versaloon/versaloon/README

vsprog.texi is the authoritative source of VSProg documentation
