versaloon/versaloon/vsf/hardware/todo.txt

1. Audio Extension
2. UI Extension(16-bit TFT + Touch panel)
3. BLDC Extension
4. Ethernet Extension
5. GSM Extension
6. WIFI Extension
7. ...
