versaloon/versaloon/(threads)

Thread 2 (2015-01-15):

Detection/usb issues (bisected)

swiftgeek, 2015-01-15:
Device: STM32L-Discovery (embedded STlink v2)
• >=1505 fails to work, doesn't need changes in code to compile
• 1443-1504 fails to compile for stm32l-discovery target, after st-link inclusion
  ∘ around time of st-link code enablement
  ∘ commenting out ST-link block - lines 65-73 - makes it compile again!
    ‣ But >1494 revision is not detected anymore by vsprog -L
    ‣ 1485-1493 doesn't compile at all (since common vsfusbd_CDC introduction)
    ‣ 1484 is latest detected after removing st-link lines
• 1442 is last detected revision for STM32L-discovery, and does work (SWD only, which is another issue)
• ~1400 do work/compile (1300 does not!)
In all successful compilation cases past r1400, /dev/ttyACM0 appears with valid PID:VID

As for bootloader i used (after adapting few lines to STM32L-discovery, due to LED/NRST being routed differently) https://github.com/snowcap-electronics/stm-versaloon/tree/master/STM32VL/Bootloader/Simon-BL
Which reminds me that it would be great to use github.io to create nice howto pages for eg. those special targets (i made some photo of connections on mine http://i.imgur.com/BRKidkw.jpg)
Another difference is that jumpers for SWD work just like on original firmware; NRST being not connected to button when board is configured to be powered via CR2032 (via solder bridges); and ofc need of -W1 when programming discovery target

Anyway this is an awesome project and it just misses some git love and documentation (provided via pull request) and improvements to funkier platforms (again pull request… github makes it much easier)

Thread 3 (2015-04-25):

项目中的使用codelite编译工程能重新配置下吗？似乎已经有许多错误了。

code2u, 2015-04-25:
这个项目中使用iar编译versaloon和用msys编译vsprog，已经配置好，编译没有问题。但是里面用codelite编译工程，作为另外一个选择，感觉很有用，但是编译的时候，发现里面的两个工程都有编译链接问题，弄了很长时间解决不了，作者能够重新配置下吗？

versaloon, 2015-04-25:
codelite是很久前配置的，一直没有更新了，近一段时间太忙，没时间去弄这个。另外，vsprog建议使用googlecode里的，github里的有一些改动，以后有空的话，会和googlecode同步的。

code2u, 2015-04-25:
这样啊，确实里面你有许多没更新了，比如iar版本，后来发现要新版本才行，5.4版本打开会丢失配置。另外想问下，vsf这个是怎样一个项目? 因为看到你那个项目一直在更新。

versaloon, 2015-04-25:
VSF是一个软件构架，基于事件驱动构架+事件驱动的PT线程的多任务协作式内核。我这里的一些应用都是用这个构架，包括USB主从协议栈，wifi的tcpip协议栈等。USB主机协议栈和wifi目前没有开源。

code2u, 2015-04-25:
原来如此，感觉你这个开源项目欠缺一些大致的说明，稍微有点乱

versaloon, 2015-04-25:
是的，这个基本只是我自己用的，开源部分代码，是因为有时候需要外包扩这兼职，需要别人看到系统的构架。这个系统构架并非很常用的多任务系统，所以我都是自己培训了之后，别人才能使用的。

code2u, 2015-04-25:
哦，这样。不知你现在忙哪方面，似乎有黑科技味道了，:-)？ 看你博客和versaloon主页，似乎也一直没更新了。

versaloon, 2015-04-25:
也不是黑科技，做一些物联网的东西。目前在弄wifi，以及tcpip协议栈。
