versaloon/versaloon/dongle/hardware/MiniRelease1/VersaloonMiniRelease1.pdf

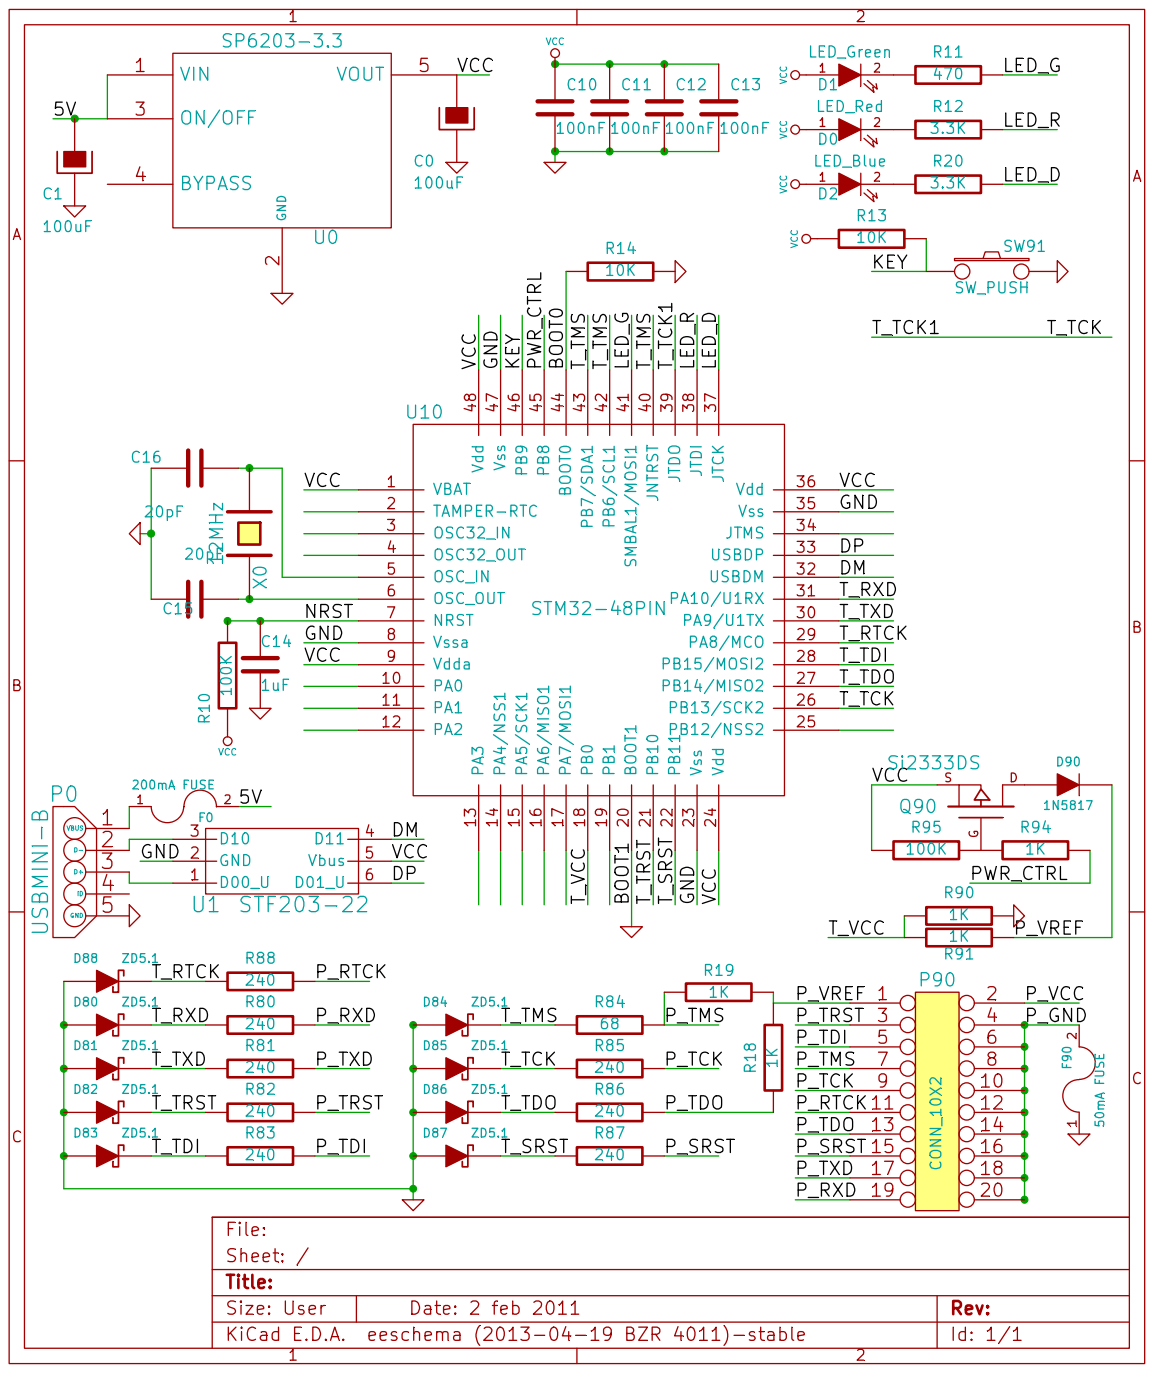
[picture p1: page 1]
