versaloon/versaloon/dongle/hardware/ProRelease3/Versaloon.kicad_pcb

## KiCad design dongle/hardware/ProRelease3/Versaloon.kicad_pcb (2014-08-10)

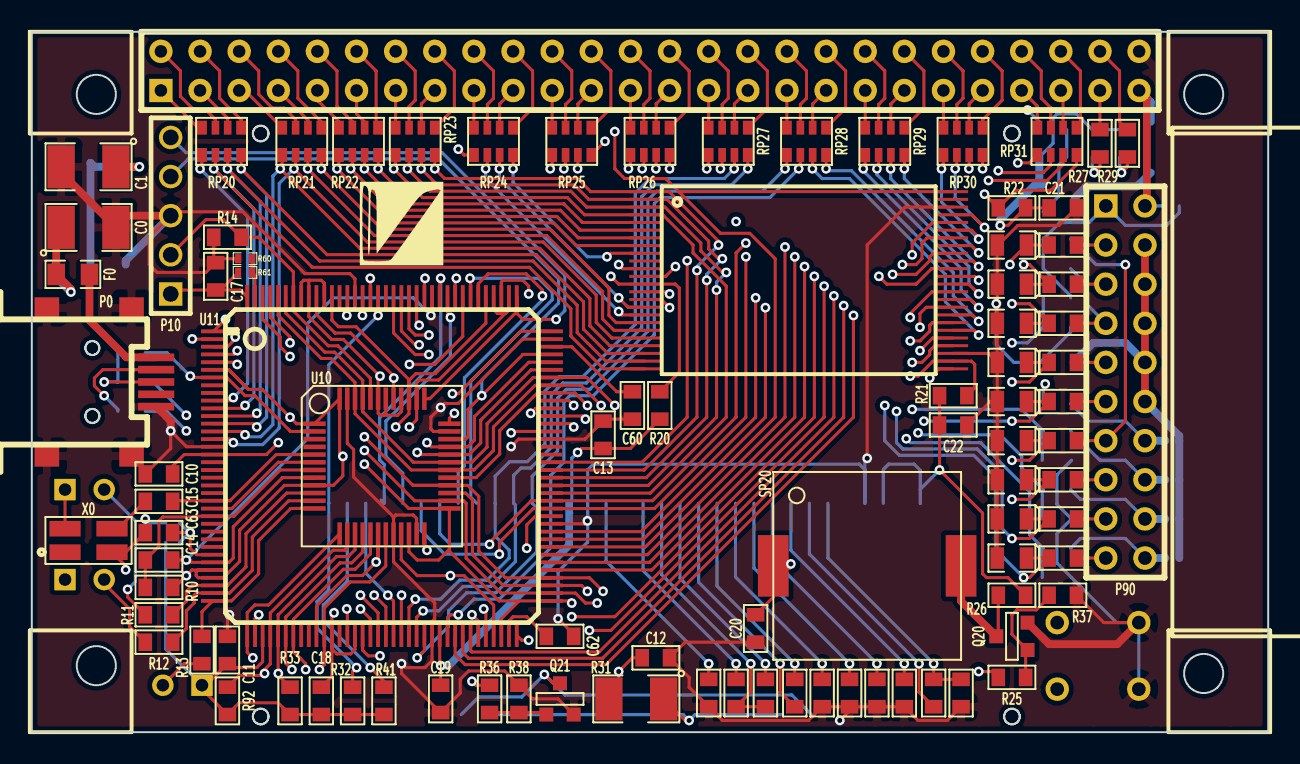
[picture p3: board dongle/hardware/ProRelease3/Versaloon.kicad_pcb from above]

Board: 4 copper layers, 80.3 x 45.5 mm, 129 parts (0 on the bottom side), 184 nets.

Parts:
C0, C1: 100uF; SM1210L
C10, C11, C12, C13, C17, C18, C19, C20, C21, C22, C60, C62, C63: 100nF; SM0603L
C14: 1uF; SM0603L
C15: 100pF; SM0603L
C23, C24, C25, C26, C27, C28, C32: 1uF/25V; SM0603L
C29, C30, C31: 104/25V; SM0603L
D0: LED_Red; LEDV
D1: LED_Green; LEDV
D2: LED_Blue; LEDV
D20, D21: LED_White; DSM0805
D70, D71, D80, D81, D82, D83, D84, D85, D86, D87, D88: ZD5.1; DSM0805
D72: ZD3.3; DSM0805
D90: 1N5817; DSM1206
F0: 200mA_FUSE; SM0805L
F90: 50mA_FUSE; SM0805L
G0: LOGO
LCM20: COG_LCM_33P; COG_12864_33P
P0: USBMINI-B; MINIUSB_A
P10: CONN_5; PIN_ARRAY_5x1
P20: CONN_26X2; PIN_ARRAY_26x2
P90: CONN_10X2; PIN_ARRAY_10x2
Q20, Q21: NPN; SOT23EBC
Q90: Si2333DS; SOT23GDS
R0, R1, R27, R29: 22; SM0603L
R2: 1.5K; SM0603L
R10, R37, R38, R95: 100K; SM0603L
R11: 470; SM0603L
R12, R13: 3.3K; SM0603L
R14, R20, R21, R22, R28, R30, R32, R33, R41, R92: 10K; SM0603L
R18, R19, R25, R26, R36, R90, R91, R94: 1K; SM0603L
R31: 300; SM1210L
R60, R61, R63, R64, R74, R75, R76, R77, R78: NC; SM0402
R70, R71, R72, R73: NC; SM0603L
R80, R81, R82, R83, R85, R86, R87, R88: 240; SM0603L
R84: 68; SM0603L
RP20, RP21, RP22, RP23, RP24, RP25, RP26, RP27, RP28, RP29, RP30, RP31: R_PACK4; RPx4
SP20: BEEPER; KLJ-1230
SW20, SW91: SW_PUSH; KEY_3x6_2Pin
U0: LM1117; SOT223
U10: STM32-48PIN; LQFP48B
U11: STM32-144PIN; TQFP144
U20: PARA_NOR_PSRAM_TSOP; TSOP48
X0: 12MHz; SMT_OSC_4025

Connections:
/5V: C0.1, F0.2, U0.3
/A0: P20.1, RP20.8
/A1: P20.2, RP20.7
/A2: P20.3, RP20.6
/A3: P20.4, RP20.5
/A4: P20.5, RP21.8
/A5: P20.6, RP21.7
/A6: P20.7, RP21.6
/A7: P20.8, RP21.5
/A8: P20.9, RP22.8
/A9: P20.10, RP22.7
/A10: P20.11, RP22.6
/A11: P20.12, RP22.5
/A12: P20.13, RP23.8
/A13: P20.14, RP23.7
/A14: P20.15, RP23.6
/A15: P20.16, RP23.5
/A16: P20.17, RP24.8
/A17: P20.18, RP24.7
/A18: P20.19, RP24.6
/A19: P20.20, RP24.5
/A20: P20.21, RP25.8
/A21: P20.22, RP25.7
/A22: P20.23, RP25.6
/A23: P20.24, RP25.5
/A24: P20.25, RP26.8
/A25: P20.26, RP26.7
/BACKLIGHT: R36.2, U10.16, U11.42
/BEEP: R25.1, U10.17, U11.43
/BOOT0: P10.2, R14.2, U10.44, U11.138
/CAN_RX: D80.2, R80.2, U10.31, U10.45, U11.102, U11.139
/CAN_TX: D81.2, R81.2, U10.30, U10.46, U11.101, U11.140
/CLK: P20.44, RP30.5
/D0: P20.27, RP26.6
/D1: P20.28, RP26.5
/D2: P20.29, RP27.8
/D3: P20.30, RP27.7
/D4: P20.31, RP27.6
/D5: P20.32, RP27.5
/D6: P20.33, RP28.8
/D7: P20.34, RP28.7
/D8: P20.35, RP28.6
/D9: P20.36, RP28.5
/D10: P20.37, RP29.8
/D11: P20.38, RP29.7
/D12: P20.39, RP29.6
/D13: P20.40, RP29.5
/D14: P20.41, RP30.8
/D15: P20.42, RP30.7
/EBI_A0: RP20.1, U11.10, U20.25
/EBI_A1: RP20.2, U11.11, U20.24
/EBI_A2: RP20.3, U11.12, U20.23
/EBI_A3: RP20.4, U11.13, U20.22
/EBI_A4: RP21.1, U11.14, U20.21
/EBI_A5: RP21.2, U11.15, U20.20
/EBI_A6: RP21.3, U11.50, U20.19
/EBI_A7: RP21.4, U11.53, U20.18
/EBI_A8: RP22.1, U11.54, U20.8
/EBI_A9: RP22.2, U11.55, U20.7
/EBI_A10: LCM20.31, RP22.3, U11.56, U20.6
/EBI_A11: RP22.4, U11.57, U20.5
/EBI_A12: RP23.1, U11.87, U20.4
/EBI_A13: RP23.2, U11.88, U20.3
/EBI_A14: RP23.3, U11.89, U20.2
/EBI_A15: RP23.4, U11.90, U20.1
/EBI_A16: RP24.1, U11.80, U20.48
/EBI_A17: RP24.2, U11.81, U20.17
/EBI_A18: RP24.3, U11.82, U20.16
/EBI_A19: RP24.4, U11.2, U20.9
/EBI_A20: RP25.1, U11.3
/EBI_A21: RP25.2, U11.4
/EBI_A22: RP25.3, U11.5
/EBI_A23: RP25.4, U11.1
/EBI_A24: RP26.1, U11.128
/EBI_A25: RP26.2, U11.129
/EBI_CLK: RP30.4, U11.117
/EBI_D0: LCM20.28, RP26.3, U11.85, U20.29
/EBI_D1: LCM20.27, RP26.4, U11.86, U20.31
/EBI_D2: LCM20.26, RP27.1, U11.114, U20.33
/EBI_D3: LCM20.25, RP27.2, U11.115, U20.35
/EBI_D4: LCM20.24, RP27.3, U11.58, U20.38
/EBI_D5: LCM20.23, RP27.4, U11.59, U20.40
/EBI_D6: LCM20.22, RP28.1, U11.60, U20.42
/EBI_D7: LCM20.21, RP28.2, U11.63, U20.44
/EBI_D8: RP28.3, U11.64, U20.30
/EBI_D9: RP28.4, U11.65, U20.32
/EBI_D10: RP29.1, U11.66, U20.34
/EBI_D11: RP29.2, U11.67, U20.36
/EBI_D12: RP29.3, U11.68, U20.39
/EBI_D13: RP29.4, U11.77, U20.41
/EBI_D14: RP30.1, U11.78, U20.43
/EBI_D15: RP30.2, U11.79, U20.45
/EBI_NCS0: R27.2, R28.1, U11.123
/EBI_NCS1: R21.1, U11.124, U20.26
/EBI_NCS2: R20.1, U11.125, U20.13
/EBI_NCS3: LCM20.33, R32.2, U11.127
/EBI_NLB: RP31.2, U11.141, U20.15
/EBI_NOE: LCM20.29, RP31.3, U11.118, U20.28
/EBI_NUB: RP31.1, U11.142, U20.14
/EBI_NWAIT: R22.1, RP31.4, U11.122
/EBI_NWE: LCM20.30, RP30.3, U11.119, U20.11
/EBI_RDY0: R29.1, R30.2, U11.91
/KEY: R92.1, SW91.1, U10.14, U11.40
/LED_D: R13.1, U10.12, U11.36
/LED_G: R11.1, U10.10, U11.34
/LED_R: R12.1, U10.11, U11.35
/NCS0: P20.49, R27.1
/NLB: P20.46, RP31.7
/NOE: P20.47, RP31.6
/NRST: C14.1, R10.1, U10.7, U11.25
/NUB: P20.45, RP31.8
/NWAIT: P20.48, RP31.5
/NWE: P20.43, RP30.6
/OSC_IN: C15.1, U10.5, U11.23
/OSC_OUT: U10.6, U11.24
/PWR_CTRL: R94.1, U10.13, U11.37
/P_ADC: P90.14, R73.1, R77.2
/P_GND: F90.2, P90.4, P90.6, P90.8, P90.10, P90.12, R74.1, R75.1, R76.1, R77.1
/P_IO: P90.16, R72.1, R76.2
/P_RTCK: P90.11, R88.1
/P_RXD: P90.19, R80.1
/P_SDIO_D6: P90.20, R70.1, R74.2
/P_SDIO_D7: P90.18, R71.1, R75.2
/P_SRST: P90.15, R87.1
/P_TCK: P90.9, R85.1
/P_TDI: P90.5, R83.1
/P_TDO: P90.13, R18.2, R86.1
/P_TMS: P90.7, R19.1, R84.1
/P_TRST: P90.3, R82.1
/P_TXD: P90.17, R81.1
/P_VCC: D90.2, P20.51, P90.2, R78.1
/P_VREF: P90.1, R18.1, R19.2, R78.2, R91.1
/RDY0: P20.50, R29.2
/SDIO_CK: D85.2, R85.2, U10.26, U10.39, U11.74, U11.113, U11.133
/SDIO_CMD: D83.2, R83.2, U10.28, U11.76, U11.116
/SDIO_D0: D86.2, R86.2, U10.27, U11.75, U11.98
/SDIO_D1: D82.2, R82.2, U10.21, U11.69, U11.99
/SDIO_D2: D84.2, R84.2, U10.40, U10.42, U10.43, U11.111, U11.134, U11.136, U11.137
/SDIO_D3: D87.2, R87.2, U10.22, U10.25, U10.38, U11.70, U11.73, U11.110, U11.112
/SDIO_D6: D70.2, R70.2, U11.96
/SDIO_D7: D71.2, R71.2, U11.97
/SELECT: R33.1, SW20.1, U10.15, U11.41
/SWCLK: P10.5, U10.37, U11.109
/SWDIO: P10.4, U10.34, U11.105
/T_ADC: R73.2, U10.19, U11.47
/T_IO: D72.2, R72.2, U10.41, U11.135
/T_RTCK: D88.2, R88.2, U10.29, U11.100
/T_VCC: R90.2, R91.2, U10.18, U11.46
/USB_DM: R0.1, U10.32, U11.103
/USB_DP: R1.1, U10.33, U11.104
/USB_PU: R2.1, U10.2, U11.7
GND: C0.2, C1.2, C10.2, C11.2, C12.2, C13.2, C14.2, C17.2, C18.2, C19.2, C20.2, C21.2, C22.2, C24.2, C25.2, C26.2, C27.2, C31.2, C32.1, C60.1, C62.1, C63.1, D70.1, D71.1, D72.1, D80.1, D81.1, D82.1, D83.1, D84.1, D85.1, D86.1, D87.1, D88.1, F90.1, LCM20.4, LCM20.19, P0.0, P0.5, P10.3, P20.52, Q20.1, Q21.1, R14.1, R37.1, R38.2, R60.2, R63.2, R90.1, SW20.2, SW91.2, U0.1, U10.8, U10.20, U10.23, U10.35, U10.47, U11.16, U11.31, U11.38, U11.48, U11.51, U11.61, U11.83, U11.94, U11.107, U11.120, U11.130, U20.27, U20.46, X0.2
unnamed: C27.1, LCM20.11
unnamed: C29.1, LCM20.14
unnamed: C31.1, LCM20.18
unnamed: Q20.2, R25.2, R37.2
unnamed: C25.1, LCM20.9
unnamed: R60.1, R61.1, U11.143
unnamed: LCM20.32, R41.2
unnamed: P0.3, R1.2, R2.2
unnamed: C15.2, X0.3
unnamed: C63.2, R63.1, R64.1, U11.30
unnamed: C62.2, U11.71
unnamed: C60.2, U11.106
unnamed: P0.2, R0.2
unnamed: D2.2, R13.2
unnamed: Q90.G, R94.2, R95.1
unnamed: D90.1, Q90.D
unnamed: F0.1, P0.1
unnamed: D1.2, R11.2
unnamed: D0.2, R12.2
unnamed: C26.1, LCM20.10
unnamed: D20.2, D21.2, Q21.3
unnamed: C28.1, LCM20.13
unnamed: C29.2, C30.2, LCM20.15
unnamed: C30.1, LCM20.16
unnamed: C24.1, LCM20.8
unnamed: C23.2, C32.2, LCM20.6
unnamed: Q20.3, R26.2, SP20.2
unnamed: D20.1, D21.1, R31.1
unnamed: C23.1, LCM20.7
unnamed: Q21.2, R36.1, R38.1
unnamed: C28.2, LCM20.12
VCC: C1.1, C10.1, C11.1, C12.1, C13.1, C17.1, C18.1, C19.1, C20.1, C21.1, C22.1, D0.1, D1.1, D2.1, LCM20.1, LCM20.3, LCM20.20, P10.1, Q90.S, R10.2, R20.2, R21.2, R22.2, R26.1, R28.2, R30.1, R31.2, R32.1, R33.2, R41.1, R61.2, R64.2, R92.2, R95.2, SP20.1, U0.2, U0.4, U10.1, U10.9, U10.24, U10.36, U10.48, U11.6, U11.17, U11.32, U11.33, U11.39, U11.52, U11.62, U11.72, U11.84, U11.95, U11.108, U11.121, U11.131, U11.144, U20.12, U20.37, X0.4
