versaloon/versaloon/dongle/hardware/NanoRelease1/Versaloon.sch

## KiCad design dongle/hardware/NanoRelease1/Versaloon.sch (2014-08-10, an earlier design)

Schematic: Versaloon.sch

Parts:
C0, C1: 100uF
C2: 100pF
C3: 105
C10, C11, C12, C13: 104
D0: LED_Red
D1: LED_Green
D2: LED_Blue
D3: DIODE
F0, F1: FUSE
P0: USB
P1: CONN_5X2
P2: TST
Q0: Si2333DS
R0, R1, R2, R9: 100K
R3, R7, R8, R10, R11: 1K
R4: 470
R5: 3.3K
R6: 4.7K
RP0, RP1: R_PACK4 68
U0: SP6203_3.3
U1: STF203-22
U2: STM32-48PIN
X0: 12MHz
