versaloon/versaloon/dongle/hardware/ProRelease1/Versaloon.sch

## KiCad design dongle/hardware/ProRelease1/Versaloon.sch (2015-04-25)

Schematic: Versaloon.sch

Parts:
C0: 1uF
C1: 100pF
C2, C3, C4, C5, C6, C7, C8, C19: 100nF
C9, C10, C12, C13, C15, C18: 47uF
C22: 47nF
D0: LED_Red
D1: LED_Green
D4: 5817
D6, D7: 4148
D10, D11, D12, D13, D14, D15, D16, D17, D18, D19, D20, D21, D22, D23, D24, D25, D26, D27, D30, D31, D32, D33, D34, D35, D36: 5.1V
D37: 3.3V
F0: 200mA FUSE
F1: 50mA FUSE
F3, F4, F5, F6, F7, F8, F9: EMI_ESD_4
L0: 330uH
P0: USB
P1: CONN_10X2
P2: DB9
P3: CONN_15X2
Q0, Q1, Q2: 8050
R0: 100K
R3, R22, R23: 3.3K
R4: 470
R11, R12, R21, R25, R34: 1K
R15, R16, R19, R20: 10K
R24: 510
R31, R32: 68
R33: 0
SP0: BEEPER
SW0: SW_PUSH
T0, T2, T3, T4, T10, T11, T12, T13, T14, T15, T16: TST
U0: STM32F200-64PIN
U1: SP6260
U2: USBLC6_2
U5: MIC2827
U6: PC817
U9: HV232
X0: 8M
