versaloon/versaloon/dongle/hardware/ProRelease2/Versaloon.sch

## KiCad design dongle/hardware/ProRelease2/Versaloon.sch (2015-04-25)

Schematic: Versaloon.sch

Parts:
C0, C1: 100uF
C2: 100pF
C4: 1uF
C5, C6, C9, C22: 100nF
D10, D91: LED_Red
D11, D30, D31, D32, D33, D34, D35, D36, D37: LED_Blue
D80, D81, D82, D83, D84, D85, D86, D87, D88: ZD5.1
D90: 1N5817
F10: 200mA FUSE
F90: 50mA FUSE
L0: LOGO
L10: LED-7COLOR
P0, P10: CONN_5
P20: TFCARD
P90: CONN_10X2
Q40: NPN
Q90: Si2333DS
R0, R95: 100K
R1, R2, R92: 0
R3, R10, R20, R21, R22, R23, R24, R25: 10K
R4, R5: 22
R6: 1.5K
R11, R13, R18, R19, R40, R41, R90, R91, R94, R96: 1K
R12: 3.3K
R14, R30, R31, R32, R33, R34, R35, R36, R37: 470
R15: 4.7K
R80, R81, R82, R83, R85, R86, R87, R88: 240
R84: 68
SP40: KLJ-1230
SW10: SW_PUSH
U0: SP6260
U2: STM32-64PIN
X0: OSCILLATOR
