versaloon/versaloon/vsf/interfaces/cpu/stm32/gpio/STM32_GPIO.c

/**************************************************************************
 *  Copyright (C) 2008 - 2010 by Simon Qian                               *
 *  SimonQian@SimonQian.com                                               *
 *                                                                        *
 *  Project:    Versaloon                                                 *
 *  File:       GPIO.h                                                    *
 *  Author:     SimonQian                                                 *
 *  Versaion:   See changelog                                             *
 *  Purpose:    GPIO interface header file                                *
 *  License:    See license                                               *
 *------------------------------------------------------------------------*
 *  Change Log:                                                           *
 *      YYYY-MM-DD:     What(by Who)                                      *
 *      2008-11-07:     created(by SimonQian)                             *
 **************************************************************************/

#include "app_type.h"
#include "interfaces.h"

#if IFS_GPIO_EN

#include "STM32_GPIO.h"

#define STM32_GPIO_NUM					7

vsf_err_t stm32_gpio_init(uint8_t index)
{
#if __VSF_DEBUG__
	if (index >= STM32_GPIO_NUM)
	{
		return VSFERR_NOT_SUPPORT;
	}
#endif
	
	RCC->APB2ENR |= RCC_APB2Periph_GPIOA << index;
	return VSFERR_NONE;
}

vsf_err_t stm32_gpio_fini(uint8_t index)
{
#if __VSF_DEBUG__
	if (index >= STM32_GPIO_NUM)
	{
		return VSFERR_NOT_SUPPORT;
	}
#endif
	
	RCC->APB2ENR &= ~(RCC_APB2Periph_GPIOA << index);
	RCC->APB2RSTR &= ~(RCC_APB2Periph_GPIOA << index);
	return VSFERR_NONE;
}

vsf_err_t stm32_gpio_config_pin(uint8_t index, uint8_t pin_idx, uint8_t mode)
{
	GPIO_TypeDef *gpio;
	uint32_t tmpreg = mode & 0x0F;
	
#if __VSF_DEBUG__
	if (index >= STM32_GPIO_NUM)
	{
		return VSFERR_NOT_SUPPORT;
	}
#endif
	
	gpio = (GPIO_TypeDef *)(GPIOA_BASE + ((uint32_t)index << 10));
	if(pin_idx < 8)
	{
		gpio->CRL = (gpio->CRL & ~(((uint32_t)0x0F) << ((pin_idx - 0) * 4))) | 
						tmpreg << ((pin_idx - 0) * 4);
	}
	else
	{
		gpio->CRH = (gpio->CRH & ~(((uint32_t)0x0F) << ((pin_idx - 8) * 4))) | 
						tmpreg << ((pin_idx - 8) * 4);
	}
	
	if(0x08 == tmpreg)
	{
		if(mode & 0x80)
		{
			gpio->BSRR = (((uint32_t)0x01) << pin_idx);
		}
		else
		{
			gpio->BRR = (((uint32_t)0x01) << pin_idx);
		}
	}
	return VSFERR_NONE;
}

vsf_err_t stm32_gpio_config(uint8_t index, uint32_t pin_mask, uint32_t io, 
							uint32_t pull_en_mask, uint32_t input_pull_mask)
{
	GPIO_TypeDef *gpio;
	uint32_t mask, tmpregl, tmpregh;
	uint8_t i;
	
#if __VSF_DEBUG__
	if (index >= STM32_GPIO_NUM)
	{
		return VSFERR_NOT_SUPPORT;
	}
#endif
	
	gpio = (GPIO_TypeDef *)(GPIOA_BASE + ((uint32_t)index << 10));
	tmpregl = gpio->CRL;
	tmpregh = gpio->CRH;
	for (i = 0; i < 8; i++)
	{
		mask = (1 << i);
		if (pin_mask & mask)
		{
			tmpregl &= ~(0x0F << (4 * i));
			if (io & mask)
			{
				tmpregl |= 0x03 << (4 * i);
				if (pull_en_mask & input_pull_mask & mask)
				{
					tmpregl |= 0x01 << (4 * i + 2);
				}
			}
			else
			{
				if (pull_en_mask & mask)
				{
					tmpregl |= 0x10 << (4 * i + 2);
				}
				else
				{
					tmpregl |= 0x01 << (4 * i + 2);
				}
			}
			if (input_pull_mask & mask)
			{
				gpio->BSRR = mask;
			}
			else
			{
				gpio->BRR = mask;
			}
		}
		mask = (1 << (i + 8));
		if (pin_mask & mask)
		{
			tmpregh &= ~(0x0F << (4 * i));
			if (io & mask)
			{
				tmpregh |= 0x03 << (4 * i);
				if (pull_en_mask & input_pull_mask & mask)
				{
					tmpregh |= 0x04 << (4 * i);
				}
			}
			else
			{
				if (pull_en_mask & mask)
				{
					tmpregh |= 0x08 << (4 * i);
				}
				else
				{
					tmpregh |= 0x04 << (4 * i);
				}
			}
			if (input_pull_mask & mask)
			{
				gpio->BSRR = mask;
			}
			else
			{
				gpio->BRR = mask;
			}
		}
	}
	gpio->CRL = tmpregl;
	gpio->CRH = tmpregh;
	return VSFERR_NONE;
}

vsf_err_t stm32_gpio_set(uint8_t index, uint32_t pin_mask)
{
	GPIO_TypeDef *gpio;
	
#if __VSF_DEBUG__
	if (index >= STM32_GPIO_NUM)
	{
		return VSFERR_NOT_SUPPORT;
	}
#endif
	
	gpio = (GPIO_TypeDef *)(GPIOA_BASE + ((uint32_t)index << 10));
	gpio->BSRR = pin_mask;
	return VSFERR_NONE;
}

vsf_err_t stm32_gpio_clear(uint8_t index, uint32_t pin_mask)
{
	GPIO_TypeDef *gpio;
	
#if __VSF_DEBUG__
	if (index >= STM32_GPIO_NUM)
	{
		return VSFERR_NOT_SUPPORT;
	}
#endif
	
	gpio = (GPIO_TypeDef *)(GPIOA_BASE + ((uint32_t)index << 10));
	gpio->BRR = pin_mask;
	return VSFERR_NONE;
}

vsf_err_t stm32_gpio_out(uint8_t index, uint32_t pin_mask, uint32_t value)
{
	GPIO_TypeDef *gpio;
	
#if __VSF_DEBUG__
	if (index >= STM32_GPIO_NUM)
	{
		return VSFERR_NOT_SUPPORT;
	}
#endif
	
	gpio = (GPIO_TypeDef *)(GPIOA_BASE + ((uint32_t)index << 10));
	gpio->BSRR = pin_mask & value;
	gpio->BRR = pin_mask & ~value;
	return VSFERR_NONE;
}

vsf_err_t stm32_gpio_in(uint8_t index, uint32_t pin_mask, uint32_t *value)
{
	GPIO_TypeDef *gpio;
	
#if __VSF_DEBUG__
	if (index >= STM32_GPIO_NUM)
	{
		return VSFERR_NOT_SUPPORT;
	}
#endif
	
	gpio = (GPIO_TypeDef *)(GPIOA_BASE + ((uint32_t)index << 10));
	*value = gpio->IDR & pin_mask;
	return VSFERR_NONE;
}

uint32_t stm32_gpio_get(uint8_t index, uint32_t pin_mask)
{
	GPIO_TypeDef *gpio;
	
#if __VSF_DEBUG__
	if (index >= STM32_GPIO_NUM)
	{
		return 0;
	}
#endif
	
	gpio = (GPIO_TypeDef *)(GPIOA_BASE + ((uint32_t)index << 10));
	return gpio->IDR & pin_mask;
}

#endif
