versaloon/versaloon/(commit log)

2014-08-10 move current vsprog from googlecode
    [VSFmem-Back.gbl, VSFmem-Front.gtl, VSFmem-InnerBack.gbr, VSFmem-InnerFront.gbr, VSFmem-Mask_Back.gbs, VSFmem-Mask_Front.gts, VSFmem-PCB_Edges.gbr, VSFmem-SilkS_Back.gbo]
2014-08-11 use 0603 PPTC for NanoRelease2 hardware
    [Versaloon-B_Mask.gbs, Versaloon-B_Paste.gbp, Versaloon-B_SilkS.gbo, Versaloon-Component.gtl, Versaloon-Copper.gbl, Versaloon-Edge_Cuts.gbr, Versaloon-F_Mask.gts, Versaloon-F_Paste.gtp]
2014-08-11 usb device stack update
2014-08-11 update for the latest usb device stack
2014-08-14 add framework under vsf, unstable version, DO NOT USE NOW
    [STM32_USART.c, app_type.h, core.c, interfaces.c, interfaces.h, main.c, vsfusbd_cfg.h]
2014-08-14 bug fix in vsftimer, now working tested with one timer
    [core.c]
2014-08-14 update timer.start_tickcnt when triggered
2014-08-15 prepare to implement the HSM framework in vsfsm
2014-08-16 add local instant event, which can not be put in event queue, and can not be sent in interrupt.
2014-08-18 vsfsm_get_event_pending should be called with interrupt disabled
2014-08-19 save sm_next in case state remove it self from the sub-statemachine list and free the vsfsm_t structure
2014-08-21 update vsfusbd to use event-driven framework of vsfsm and vsftimer
2014-08-21 usbd->connect is not called in vsfusbd, should be called outside when the USB device is ready to connect
2014-08-22 vsftimer trigger source is implemented in application, instead of using tickclk interrupt by default, so user application can use a longer trigger source
2014-08-23 1. use interfaces->tickclk.get_count instead of clock() in timer.h 2. move app_type.h to vsf 3. use libusb-1.0
2014-08-23 add new NanoRelease2 PCB design, add 2 indicating LEDs
    [Versaloon-B_Mask.gbs, Versaloon-B_Paste.gbp, Versaloon-B_SilkS.gbo, Versaloon-Component.gtl, Versaloon-Copper.gbl, Versaloon-Edge_Cuts.gbr, Versaloon-F_Mask.gts, Versaloon-F_Paste.gtp]
2014-08-24 adjust position of 2 LEDs on NanoRelease2 hardware
    [Versaloon-B_Mask.gbs, Versaloon-B_Paste.gbp, Versaloon-B_SilkS.gbo, Versaloon-Component.gtl, Versaloon-Copper.gbl, Versaloon-Edge_Cuts.gbr, Versaloon-F_Mask.gts, Versaloon-F_Paste.gtp]
2014-08-25 fix indent in example/vsfusbd_eda/main.c
    [main.c]
2014-08-25 rename stm32 project to EWARM7.10_STM32
2014-08-25 remove sst32hfxx_drv.c in STM32 project of vsfusbd_eda example
2014-08-27 add stm32f40x, stm32f42x and stm32f43x support
2014-08-27 detect flash_ram size for stm32f2 and stm32f4
2014-08-27 remove control_status in usbd driver
2014-08-31 remove interfaces->adc.sample
2014-08-31 remove official library for stm32 from ST, not tested
2014-08-31 add startup files for stm32
2014-09-01 use TIM5 only for STM32 tickclk
2014-09-01 STM32 USBD fix, now working tested on vsfusbd_eda example
    [core.c]
2014-09-02 nuc400 usbd driver update
2014-09-02 adjust position of a LDO in NanoRelease2 so that the PAD is not too close to edge of PCB
    [Versaloon-B_Mask.gbs, Versaloon-B_Paste.gbp, Versaloon-B_SilkS.gbo, Versaloon-Component.gtl, Versaloon-Copper.gbl, Versaloon-Edge_Cuts.gbr, Versaloon-F_Mask.gts, Versaloon-F_Paste.gtp]
2014-09-04 for swd_transact, return FAIL if current transact is not succeed
2014-09-14 remove usart.poll and adc.sample, add int_priority to usart.config_callback
2014-09-16 NanoRelease2 hardware update, move components a bit far away from the edge of PCB
    [Versaloon-B_Mask.gbs, Versaloon-B_Paste.gbp, Versaloon-B_SilkS.gbo, Versaloon-Component.gtl, Versaloon-Copper.gbl, Versaloon-Edge_Cuts.gbr, Versaloon-F_Mask.gts, Versaloon-F_Paste.gtp]
2014-09-19 add stm32f4 interfaces.h(not implemented) and example for vsfusbd_eda
2014-09-20 fix stm32f2/4 support, write unlock key will fail is already unlocked
2014-10-12 fix compile problem under linux
    [app_log.h, vi_stm32.c]
2014-10-13 vsfsm update for prototype implementation
2015-04-25 sync to vsprog in google code
    [Connect-Back.gbl, Connect-Front.gtl, Connect-Mask_Back.gbs, Connect-Mask_Front.gts, Connect-PCB_Edges.gbr, Connect-SilkS_Back.gbo, Connect-SilkS_Front.gto, Connect-SoldP_Back.gbp]
2015-12-29 add support for 4byte address for SPI dataflash
